donpivo/Thermostat/README.md

Description:
https://retronics.no/2023/11/08/diy-high-temperature-programmable-thermostat/
