donpivo/Thermostat/Schematic/Thermostat.kicad_pcb

## KiCad design Schematic/Thermostat.kicad_pcb (2023-10-19)

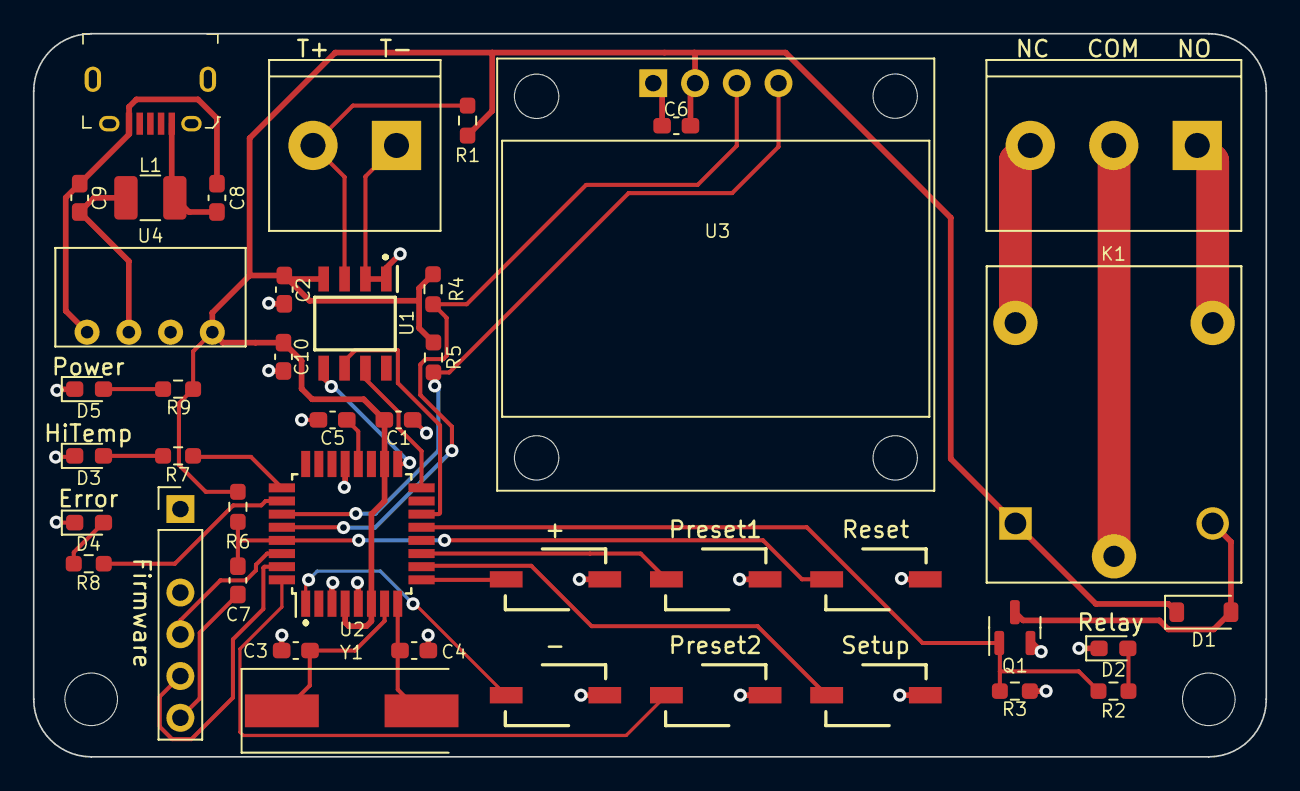
[picture p1: board Thermostat.kicad_pcb from above]

Board: 2 copper layers, 75.0 x 44.0 mm, 44 parts (0 on the bottom side), 34 nets.

Parts:
C1, C2, C5: 100nF; C_0603_1608Metric_Pad1.08x0.95mm_HandSolder
C3, C4: 22pF; C_0603_1608Metric_Pad1.08x0.95mm_HandSolder
C6: 1µF; C_0603_1608Metric_Pad1.08x0.95mm_HandSolder
C7: 10nF; C_0603_1608Metric_Pad1.08x0.95mm_HandSolder
C8, C9: 4.7µF; C_0603_1608Metric_Pad1.08x0.95mm_HandSolder
C10: 10µF; C_0603_1608Metric_Pad1.08x0.95mm_HandSolder
D1: 1N5819W; D_SOD-123
D2: Yellow; LED_0603_1608Metric_Pad1.05x0.95mm_HandSolder
D3: Orange; LED_0603_1608Metric_Pad1.05x0.95mm_HandSolder
D4: Red; LED_0603_1608Metric_Pad1.05x0.95mm_HandSolder
D5: Green; LED_0603_1608Metric_Pad1.05x0.95mm_HandSolder
H1, H2: MountingHole; MountingHole_3.2mm_M3
J1: Relay conn.; ScrewTerminal_DB128L-5.08-3P-BK-S
J2: Thermocouple; ScrewTerminal_DB128L-5.08-2P-BK-S
J3: Firmware; PinHeader_1x06_P2.54mm_Vertical_Minus2
J4: USB_B_Micro; USB_Micro_B_Female_10118194-0001LF
K1: SONGLE_SRD_05VDC_SL_C; RELAY_SRD-05VDC-SL-C
L1: CBC3225T6R8MR; L_1210_3225Metric_Pad1.42x2.65mm_HandSolder
Q1: BSS138; SOT-23
R1: 1MΩ; R_0603_1608Metric_Pad0.98x0.95mm_HandSolder
R2, R7, R8, R9: 1kΩ; R_0603_1608Metric_Pad0.98x0.95mm_HandSolder
R3, R6: 10kΩ; R_0603_1608Metric_Pad0.98x0.95mm_HandSolder
R4, R5: 4.7kΩ; R_0603_1608Metric_Pad0.98x0.95mm_HandSolder
SW1: Temp+; AlpsAlpine_SKQYPCE010
SW2: Preset1; AlpsAlpine_SKQYPCE010
SW3: Reset; AlpsAlpine_SKQYPCE010
SW4: Temp-; AlpsAlpine_SKQYPCE010
SW5: Preset2; AlpsAlpine_SKQYPCE010
SW6: Setup; AlpsAlpine_SKQYPCE010
U1: MAX6675; SOIC127P600X175-8N
U2: ATMEGA328P-AU; TQFP-32_7x7mm_P0.8mm
U3: Display_OLED_0.96_I2C; Display_OLED_0.96in_I2C
U4: B0505S-1WR3; B0505S
Y1: 16MHz; Crystal_SMD_HC49-SD

Connections:
+5V: C1.1, C2.1, C6.1, C10.2, D1.1 (K), K1.A1, R1.1, R4.1, R5.1, R6.1, R9.1, U1.4 (VCC), U2.4 (VCC), U2.6 (VCC), U2.18 (AVCC), U3.2 (VCC), U4.4 (VOUT)
Earth: C8.1, C9.1, J4.5 (GND), U4.1 (GND)
GND: C1.2, C2.2, C3.2, C4.2, C5.1, C6.2, C10.1, D2.1 (K), D3.1 (K), D4.1 (K), D5.1 (K), J2.1, J3.1, Q1.2 (S), R3.2, SW1.2, SW2.2, SW3.2, SW4.2, SW5.2, SW6.2, U1.1 (GND), U1.2 (T-), U2.3 (GND), U2.5 (GND), U2.21 (GND), U3.1 (GND), U4.3 (0V)
LED_ERROR: R8.1, U2.26 (A3)
LED_HITEMP: R7.1, U2.25 (A2)
unnamed: D1.2 (A), K1.A2, Q1.3 (D)
unnamed: D2.2 (A), R2.2
unnamed: D3.2 (A), R7.2
unnamed: D4.2 (A), R8.2
unnamed: D5.2 (A), R9.2
unnamed: J1.1, K1.NO
unnamed: J1.2, K1.COM
unnamed: J1.3, K1.NC
unnamed: J2.2, R1.2, U1.3 (T+)
unnamed: J3.4, U2.30 (D0/RX)
unnamed: J3.5, U2.31 (D1/TX)
unnamed: C7.1, J3.6
unnamed: C8.2, J4.1 (VBUS), L1.1
unnamed: C5.2, U2.20 (AREF)
unnamed: C3.1, U2.7 (XTAL1), Y1.1
unnamed: C4.1, U2.8 (XTAL2), Y1.2
unnamed: C9.2, L1.2, U4.2 (VIN)
RLY_CTRL: Q1.1 (G), R2.1, R3.1, U2.13 (D9(PWM))
SCL: R4.2, U2.28 (A5/SCL), U3.3 (SCL)
SDA: R5.2, U2.27 (A4/SDA), U3.4 (SDA)
SPI_CS: U1.6 (~CS), U2.14 (D10(PWM)/SS)
SPI_MISO: U1.7 (SO), U2.16 (D12/MISO)
SPI_SCK: U1.5 (SCK), U2.17 (D13/SCK)
SW_Preset1: SW2.1, U2.11 (D7)
SW_Preset2: SW5.1, U2.32 (D2/INT0)
SW_Reset: C7.2, R6.2, SW3.1, U2.29 (~RESET)
SW_Setup: SW6.1, U2.10 (D6(PWM))
SW_Temp+: SW1.1, U2.9 (D5(PWM))
SW_Temp-: SW4.1, U2.1 (D3(PWM)/INT1)
