donpivo/Thermostat/(commit log)

2023-09-12 Added status LEDs, changed button functions
    [Thermostat.kicad_pcb, Thermostat.kicad_sch, bom.csv, designators.csv, positions.csv]
2023-10-04 Added pull-up/pull-down resistors for sensor, removed redundant LEDs
    [Thermostat.kicad_pcb, Thermostat.kicad_sch, bom.csv, designators.csv, positions.csv]
2023-10-16 Altered button configuration
    [Thermostat.kicad_pcb, Thermostat.kicad_sch]
2023-10-19 Added status LEDs, rearranged buttons
    [Thermostat.kicad_pcb, Thermostat.kicad_sch, bom.csv, designators.csv, positions.csv]
2023-11-24 Corrected behavior at sensor error
    [main.cpp]
